akutney/micromouse2020/README.md

# Getting Started

Get started with the following links:

- [Environment Setup](docs/Environment%20Setup.md)
- [Project Structure](docs/Project%20Structure.md)
- [Development Lifecycle](docs/Development%20Lifecycle.md)
