akutney/micromouse2020/Part1.DXF

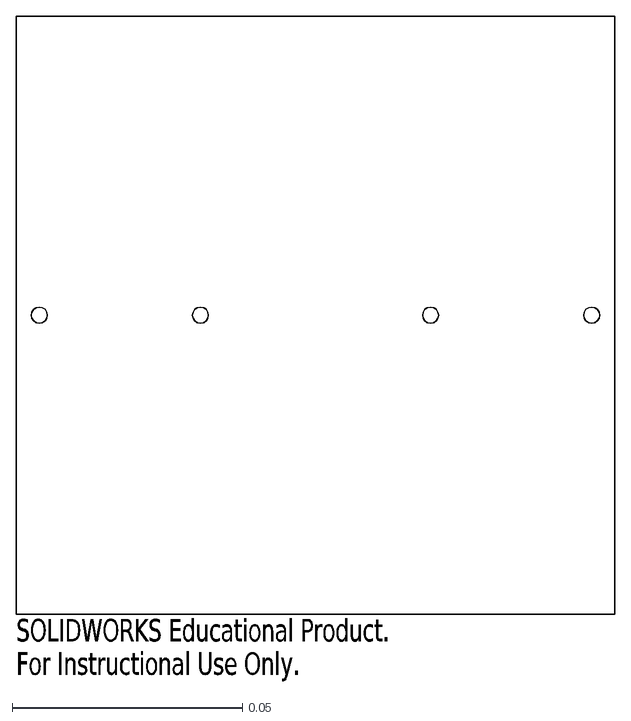
[picture p1: CAD file, 2021-11-04]
Part1.DXF
SOLIDWORKS Educational Product.
For Instructional Use Only.
