akutney/micromouse2020/software/octave/controller/controller_test.png

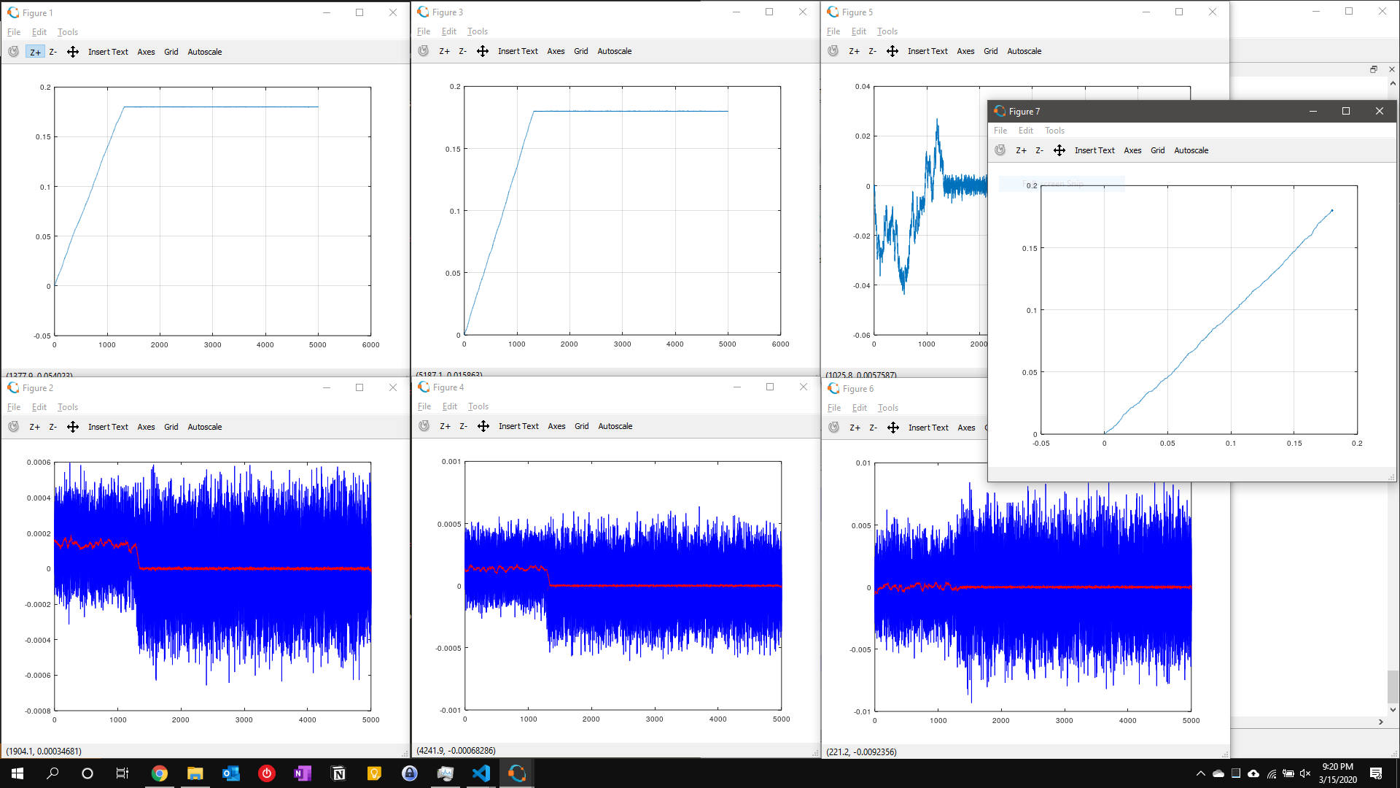
software/octave/controller/controller_test.png
