akutney/micromouse2020/pcb/Rev 1.pdf

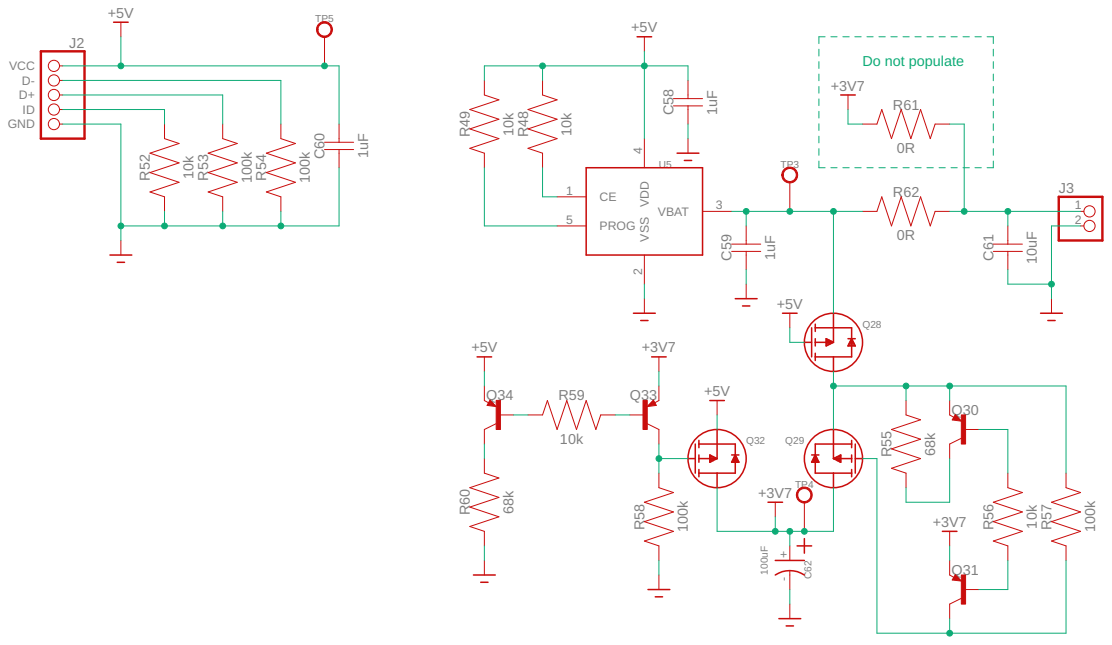
[picture p3: page 1]

1uF 1uF 10k 10k +5V 10k 100k 100k1uF +5V 10uF +5V 68k 10k 100k +3V7 +5V +3V7 100k +3V7 10k +5V 68k 0R0R +3V7 100uF CE 1 VSS 2 VBAT V3 DD 4 PROG 5 U5C58 C59 R48 R49 VCCD- D+ID GND J2 R52 R53 R54C60 12 J3 C61 Q28 Q29 Q30 R55 Q31 R56 R57 Q32 Q33R58 Q34 R59 R60 R61 R62 TP3TP4 TP5 + -C62 Do not populate

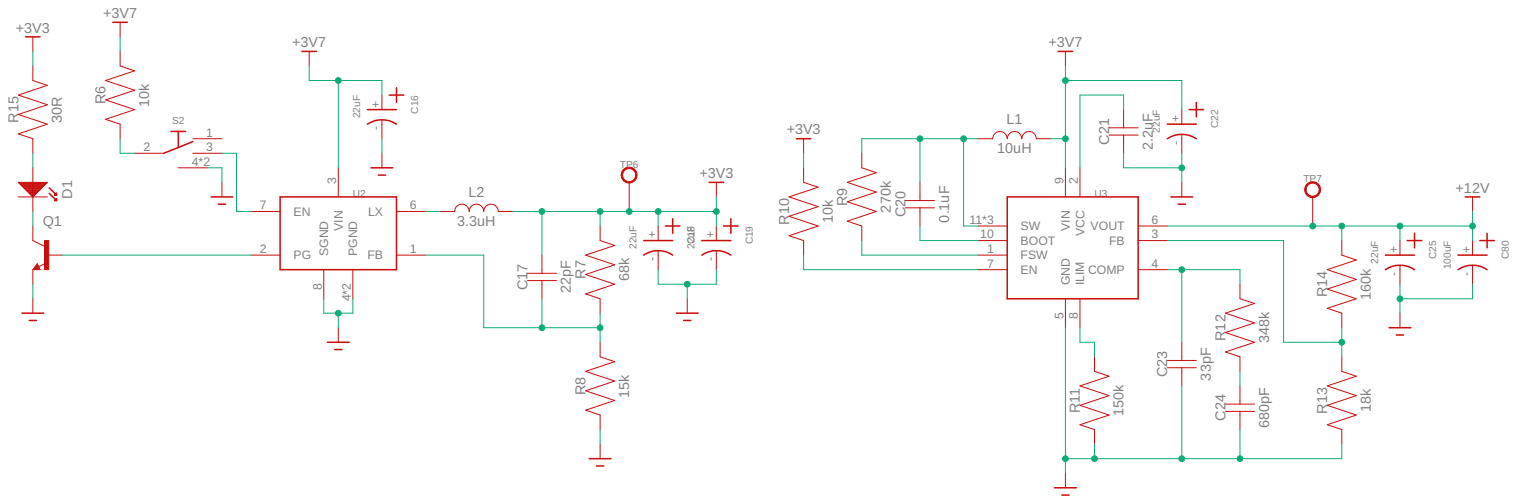
[picture p4: page 2]

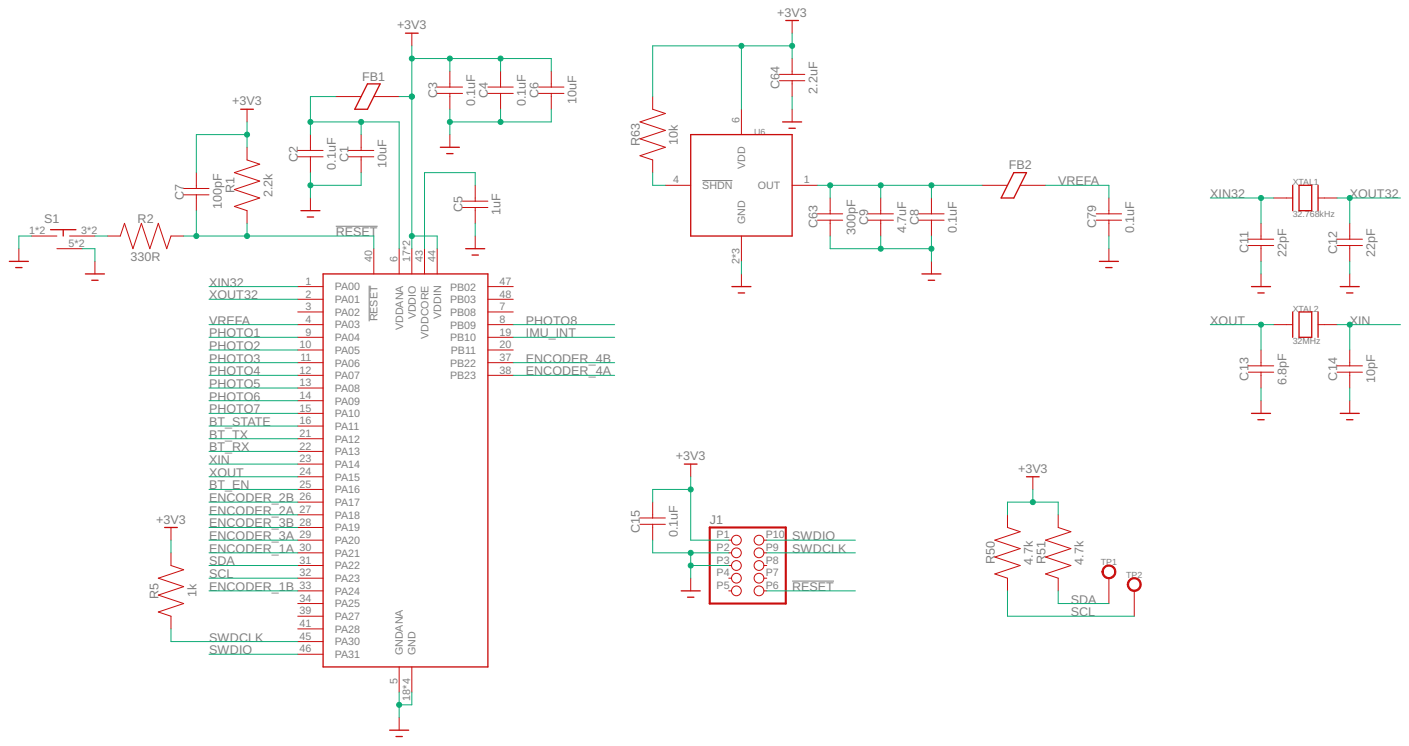
[picture p5: page 3]

10uF 0.1uF 0.1uF 0.1uF 2.2k 10uF +3V3 +3V3 1uF100pF 330R 0.1uF 4.7uF +3V3 32.768kHz 22pF 22pF 32MHz 6.8pF 10pF 1k +3V3 +3V3 0.1uF 4.7k 4.7k +3V3 300pF 10k 2.2uF 0.1uF PA00 1 PA01 2 PA02 3 PA03 4 PA04 9 PA05 10 PA06 11 PA07 12 PA08 13 PA09 14 PA10 15 PA11 16 PA12 21 PA13 22 PA14 23 PA15 24 PA16 25 PA17 26 PA18 27 PA19 28 PA20 29 PA21 30 PA22 31 PA23 32 PA24 33 PA25 34 PA27 39 PA28 41 PA30 45 PA31 46 PB08 7 PB09 8 PB10 19 PB11 20 PB22 37 PB23 38 PB02 47 PB03 48 RESET 40 VDDANA 6 VDDIO 17*2 VDDCORE 43 VDDIN 44 GNDANA 5 GND 18*4 C1 C2 C3 C4 R1 C6 C C5 7 R2 1*2 3*2 5*2 S1 C8 C9 XTAL1 C11 C12 XTAL2 C13 C14 P1 P10 P2 P9 P3 P8 P4 P7 P5 P6 J1 R5 C15 R50 R51 FB1 VDD 6 SHDN 4 GND 2*3 OUT 1 U6 C63 R63 C64 TP1 TP2 FB2 C79 RESET RESET VREFA VREFA XIN32 XIN32 XOUT32 XOUT32 XIN XIN XOUT XOUT SWDIO SWDIO SWDCLK SWDCLK SDA SDA SCL SCL BT_TX BT_RX PHOTO8 PHOTO1 PHOTO2 PHOTO3 PHOTO4 PHOTO5 PHOTO6 PHOTO7 IMU_INT BT_STATE BT_EN ENCODER_2B ENCODER_2A ENCODER_3B ENCODER_3A ENCODER_1A ENCODER_4B ENCODER_4A ENCODER_1B

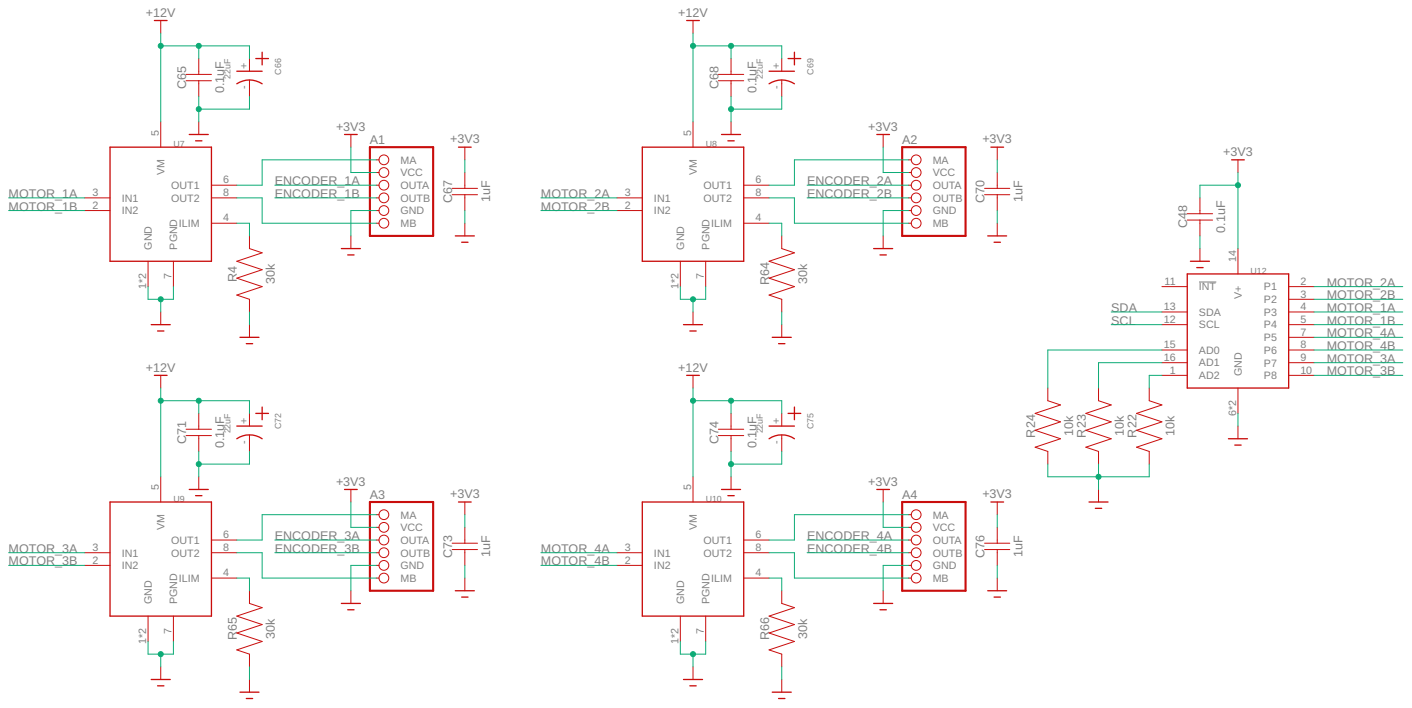
[picture p6: page 4]

30k 0.1uF 22uF +12V +3V3 +3V3 1uF 30k 0.1uF 22uF +12V +3V3 +3V3 1uF 30k 0.1uF 22uF +12V +3V3 +3V3 1uF 30k 0.1uF 22uF +12V +3V3 +3V3 1uF 10k 10k 10k +3V3 0.1uF GND 1*2 PGND 7 IN1 3 IN2 2 OUT1 6 OUT2 8 ILIM 4 VM 5 U7 R4 C65+ - C66 MAVCC OUTA OUTB GND MB A1 C67 GND 1*2 PGND 7 IN1 3 IN2 2 OUT1 6 OUT2 8 ILIM 4 VM 5 U8 R64 C68+ - C69 MAVCC OUTA OUTB GND MB A2 C70 GND 1*2 PGND 7 IN1 3 IN2 2 OUT1 6 OUT2 8 ILIM 4 VM 5 U9 R65 C71+ - C72 MAVCC OUTA OUTB GND MB A3 C73 GND 1*2 PGND 7 IN1 3 IN2 2 OUT1 6 OUT2 8 ILIM 4 VM 5 U10 R66 C74+ - C75 MAVCC OUTA OUTB GND MB A4 C76 P1 2 P2 3 P3 4 P4 5 P5 7 P6 8 P7 9 P8 10 AD0 15 AD1 16 AD2 1 SCL 12 SDA 13 INT 11 GND 6*2 V+ 14 U12 R22 R23 R24 C48 MOTOR_1A MOTOR_1A MOTOR_1B MOTOR_1B ENCODER_1A ENCODER_1B MOTOR_2A MOTOR_2A MOTOR_2B MOTOR_2B ENCODER_2A ENCODER_2B MOTOR_3A MOTOR_3A MOTOR_3B MOTOR_3B ENCODER_3A ENCODER_3B MOTOR_4A MOTOR_4A MOTOR_4B MOTOR_4B ENCODER_4A ENCODER_4B SDA SCL

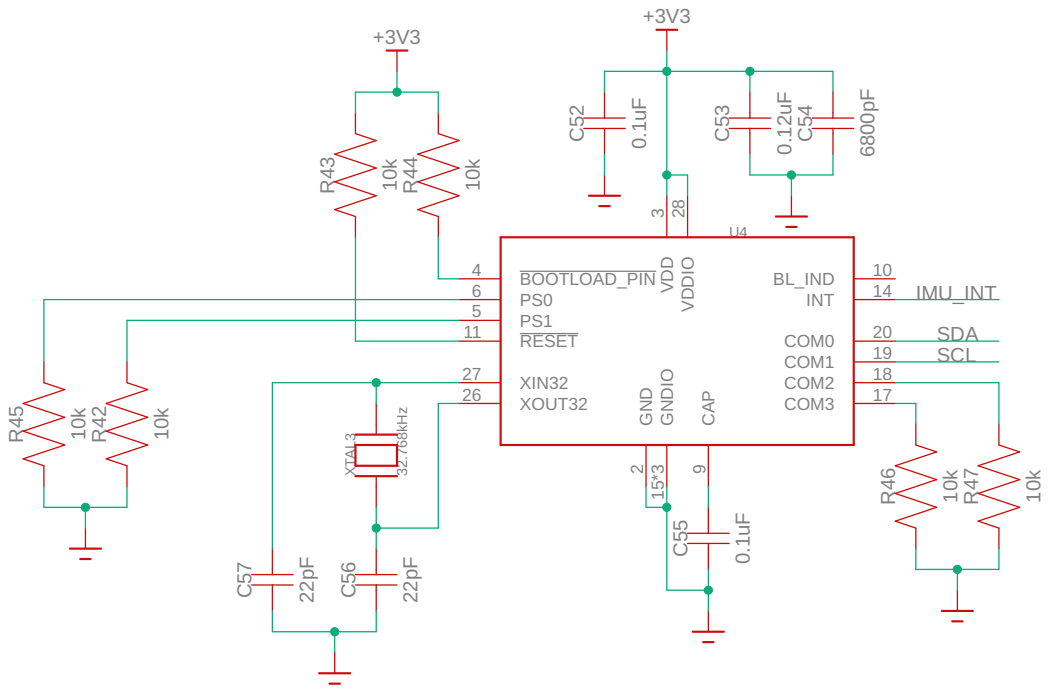
[picture p7: page 5]

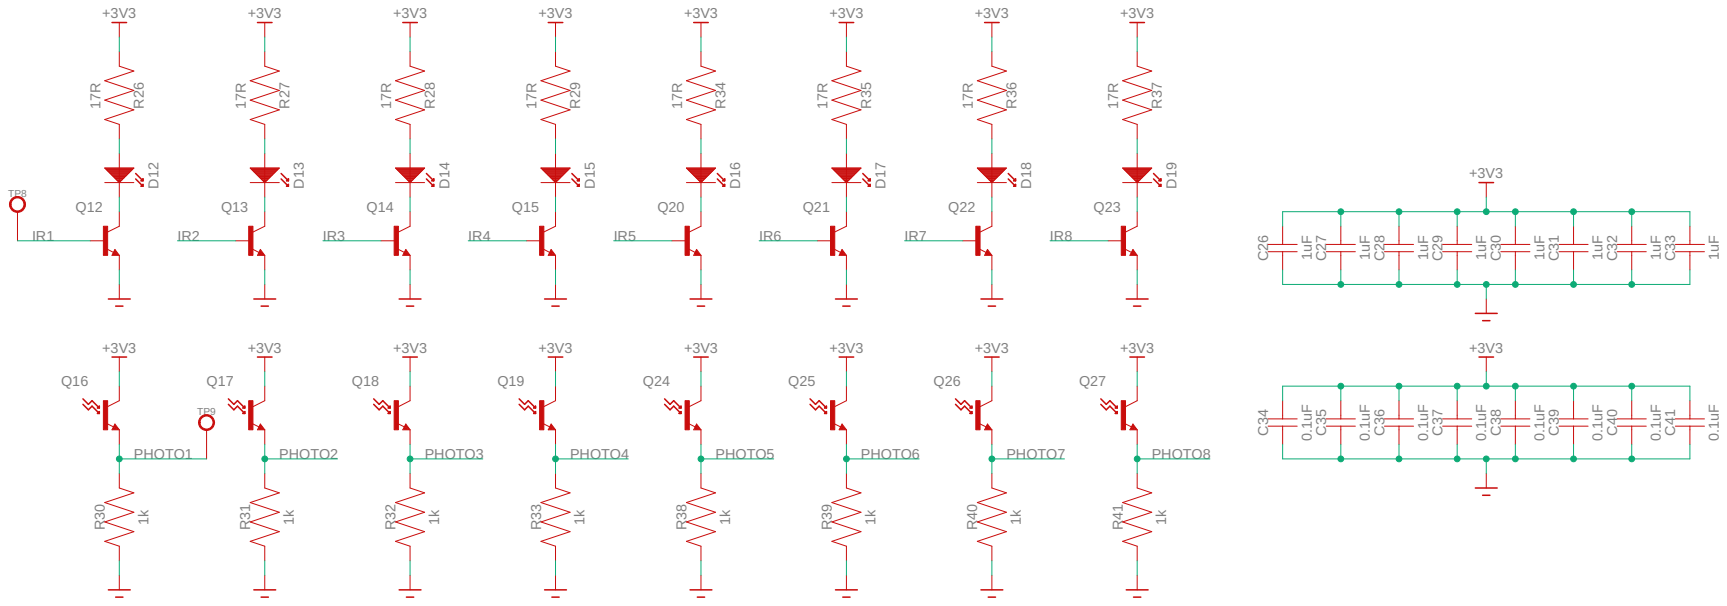
[picture p8: page 6]

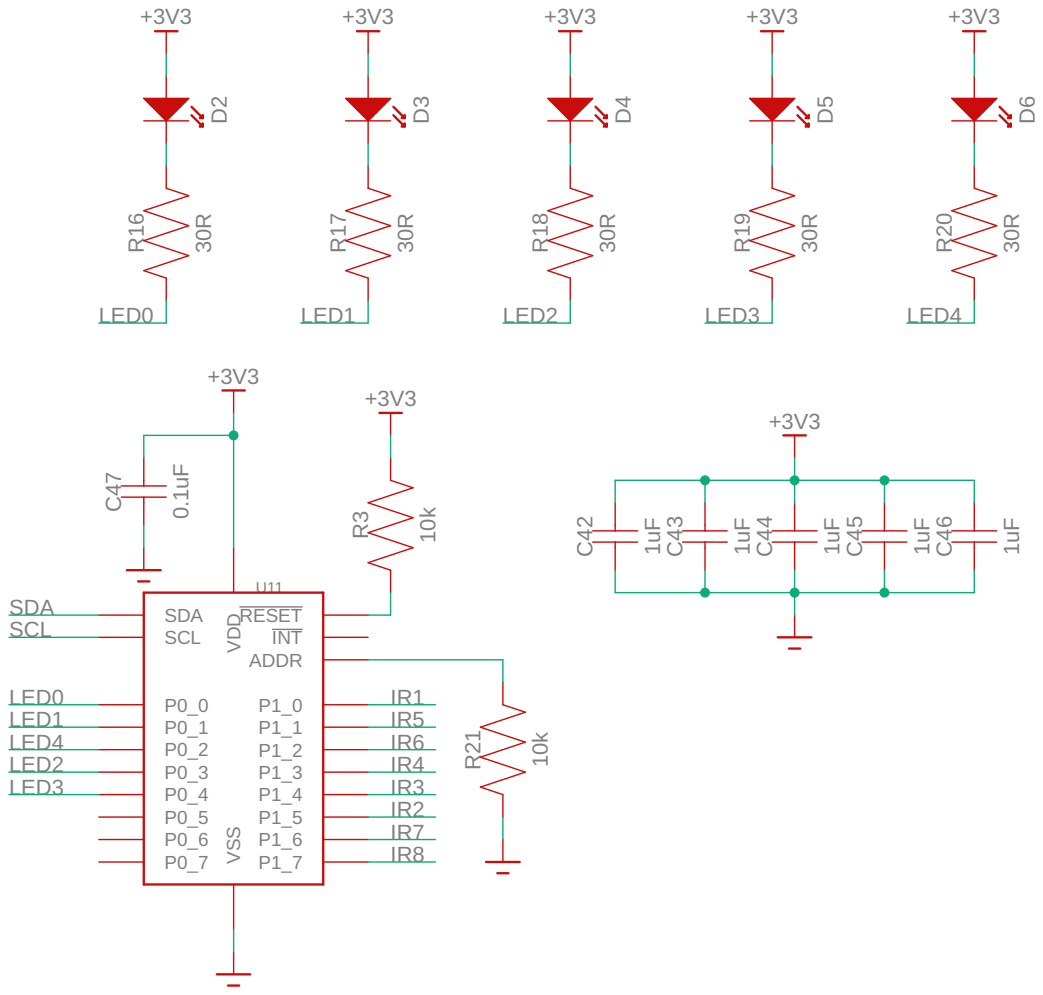
[picture p9: page 7]

INT RESET SCL SDA

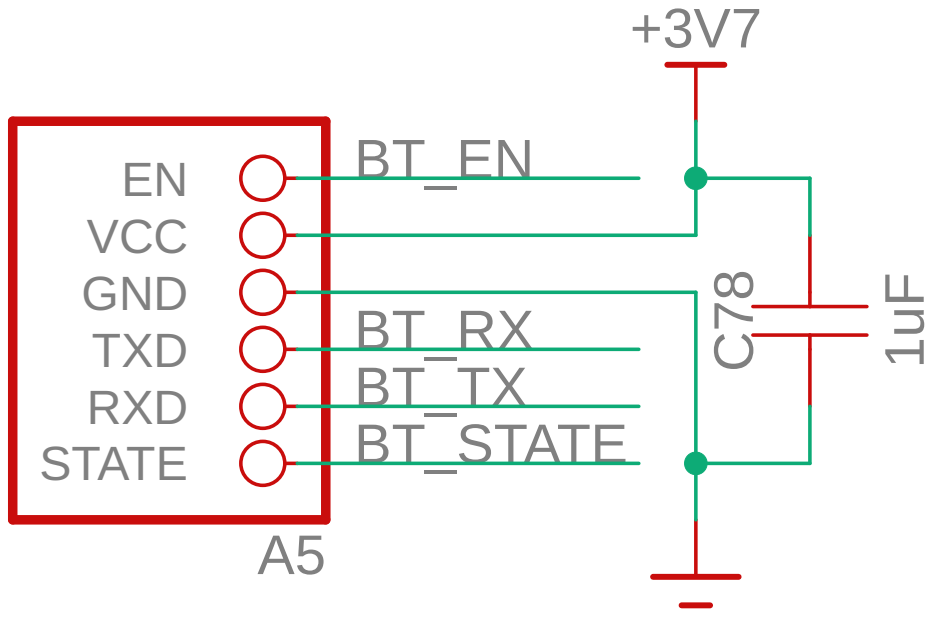
[picture p10: page 8]

1uF +3V7 STATE RXD TXD GND VCCEN A5 C78 BT_RX BT_TX BT_STATE BT_EN
