akutney/micromouse2020/pcb/EncoderR1.pdf

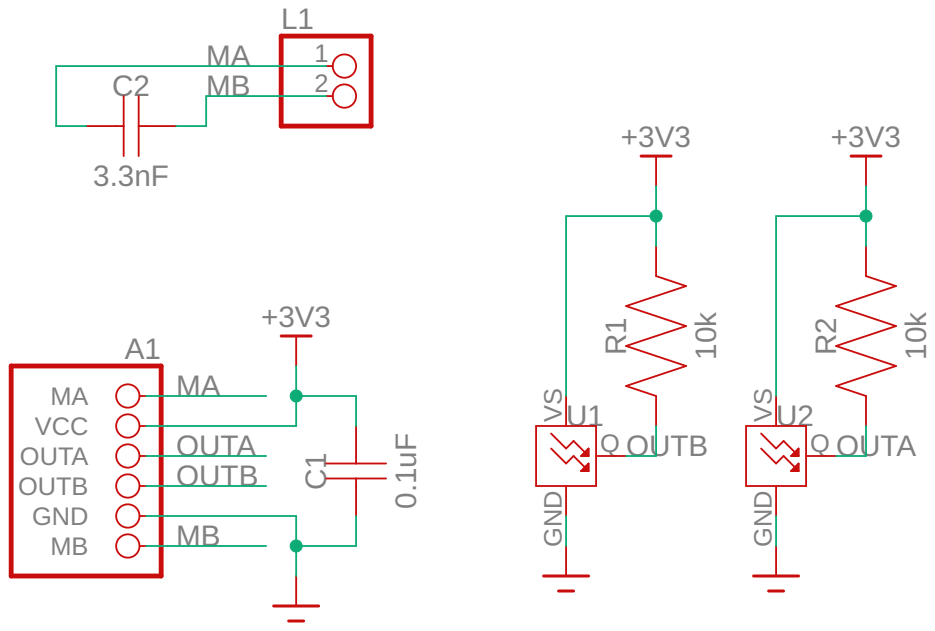
[picture p11: page 1]
