akutney/micromouse2020/pcb/EncoderR1.brd

## EAGLE design pcb/EncoderR1.brd (2020-02-26)

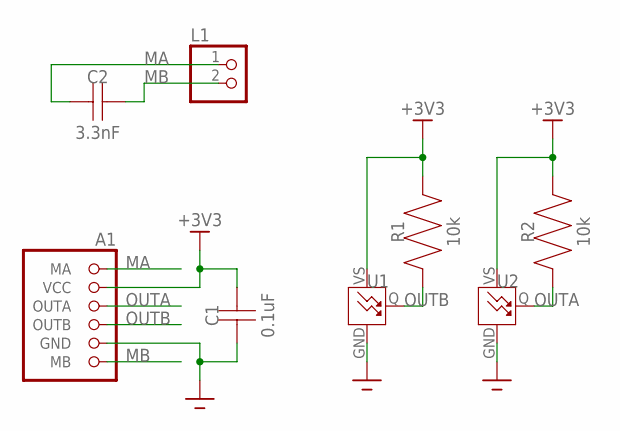
[picture p12: schematic EncoderR1.sch]

Parts:
A1: ENCODER; ENCODER-TAB
C1: 0.1uF; 0603
C2: 3.3nF; 0603
L1: MOTOR
R1, R2: 10k; 0603
U1, U2: TLE49462KHTSA1

Connections:
+3V3: A1.2 (VCC), C1.2, R1.2, R2.2, U1.VS, U2.VS
GND: A1.5 (GND), C1.1, U1.GND, U2.GND
MA: A1.1 (MA), C2.1, L1.1
MB: A1.6 (MB), C2.2, L1.2
OUTA: A1.3 (OUTA), R2.1, U2.Q
OUTB: A1.4 (OUTB), R1.1, U1.Q

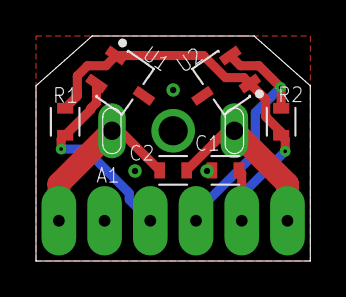
[picture p13: board EncoderR1.brd from above]

Board: 2 copper layers, 15.2 x 12.5 mm, 8 parts (0 on the bottom side), 6 nets.
