akutney/micromouse2020/pcb/Rev 1.brd

## EAGLE design pcb/Rev 1.brd (2020-02-26)

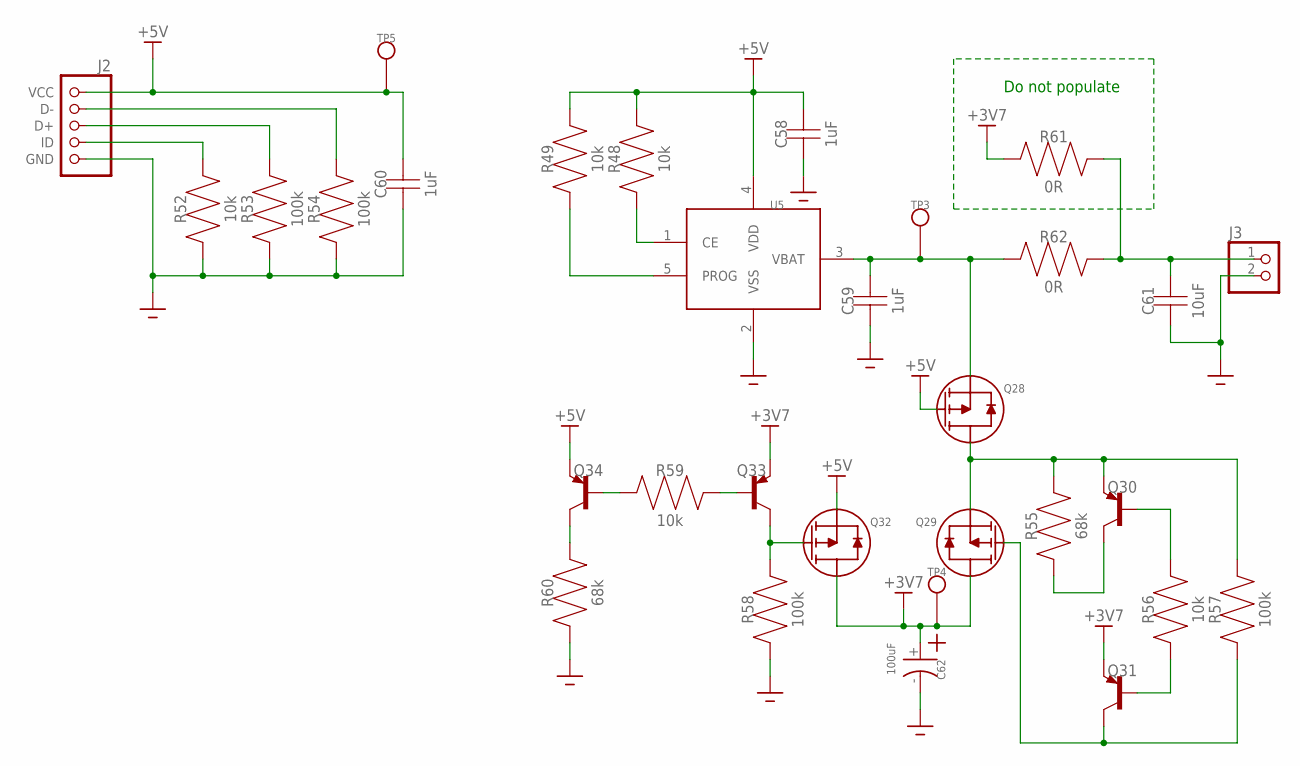
[picture p14: schematic Rev 1.sch, sheet 1, Battery and Charger]

Parts:
C58, C59, C60: 1uF; 0805
C61: 10uF; 0805
C62: 100uF; EEE-1EA101AP
J2: 10118194-0001LF
J3: B2B-PH-K-S(LF)(SN)
Q28, Q29, Q32: SI7157DP
Q30, Q31, Q33, Q34: MMBT3906; SOT96P237X112-3
R48, R49, R52: 10k; 0402
R53, R54: 100k; 0402
R55: 68k; 0603
R56: 10k; 0603
R57: 100k; 0603
R58: 100k; 0805
R59: 10k; 0805
R60: 68k; 0805
R61, R62: 0R; 0805
TP3, TP4, TP5: TESTPOINT
U5: MCP73811

Connections:
+3V7: C62.+, Q29.5 (D), Q29.6 (D), Q29.7 (D), Q29.8 (D), Q29.9 (D), Q29.10 (D), Q29.11 (D), Q31.2 (E), Q32.5 (D), Q32.6 (D), Q32.7 (D), Q32.8 (D), Q32.9 (D), Q32.10 (D), Q32.11 (D), Q33.2 (E), R61.P$1, TP4.P1; also elsewhere on the board
+5V: C58.P$2, C60.P$2, J2.1 (VCC), Q28.4 (G), Q32.1 (S), Q32.2 (S), Q32.3 (S), Q34.2 (E), R48.2, R49.2, TP5.P1, U5.4 (VDD)
GND: C58.P$1, C59.P$1, C60.P$1, C61.P$1, C62.-, J2.5 (GND), J2.6 (GND), J2.7 (GND), J2.8 (GND), J2.9 (GND), J2.10 (GND), J2.11 (GND), J2.12 (GND), J2.13 (GND), J2.14 (GND), J2.15 (GND), J3.2, R52.1, R53.1, R54.1, R58.P$1, R60.P$1, U5.2 (VSS); also elsewhere on the board
unnamed: C59.P$2, Q28.1 (S), Q28.2 (S), Q28.3 (S), R62.P$1, TP3.P1, U5.3 (VBAT)
unnamed: R48.1, U5.1 (CE)
unnamed: R49.1, U5.5 (PROG)
unnamed: Q30.3 (C), R55.1
unnamed: Q28.5 (D), Q28.6 (D), Q28.7 (D), Q28.8 (D), Q28.9 (D), Q28.10 (D), Q28.11 (D), Q29.1 (S), Q29.2 (S), Q29.3 (S), Q30.2 (E), R55.2, R57.2
unnamed: Q31.1 (B), R56.1
unnamed: Q30.1 (B), R56.2
unnamed: J2.4 (ID), R52.2
unnamed: J2.3 (D+), R53.2
unnamed: J2.2 (D-), R54.2
unnamed: Q29.4 (G), Q31.3 (C), R57.1
unnamed: Q32.4 (G), Q33.3 (C), R58.P$2
unnamed: Q34.1 (B), R59.P$1
unnamed: Q33.1 (B), R59.P$2
unnamed: Q34.3 (C), R60.P$2
unnamed: C61.P$2, J3.1, R61.P$2, R62.P$2

Notes on the sheet:
Do not populate

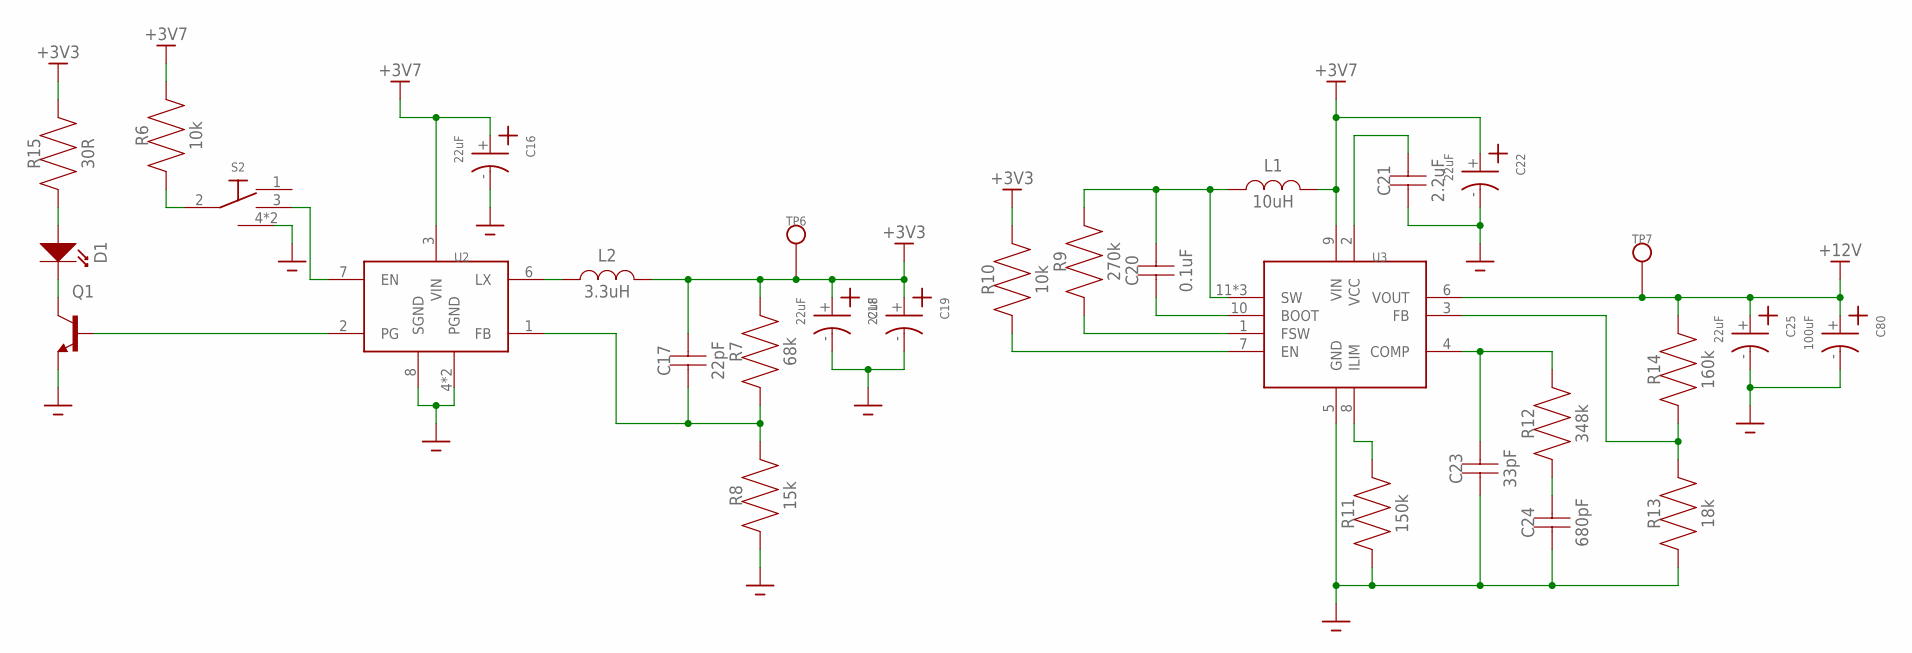
[picture p15: schematic Rev 1.sch, sheet 2, Power Regulation]

Parts:
C16, C18, C19, C22, C25: 22uF; 865080542006
C17: 22pF; 0805
C20: 0.1uF; 0402
C21: 2.2uF; 0402
C23: 33pF; 0402
C24: 680pF; 0402
C80: 100uF; EEE-1EA101AP
D1: LED1206; 1206
L1: 10uH; 104CDMCC
L2: 3.3uH; NRS5040
Q1: MMBT3904,215MMBT3904,215; SOT95P230X110-3
R6: 10k; 0805
R7: 68k; 0805
R8: 15k; 0805
R9: 270k; 0402
R10: 10k; 0603
R11: 150k; 0603
R12: 348k; 0402
R13: 18k; 0402
R14: 160k; 0402
R15: 30R; 0805
S2: OS102011MS2QN1
TP6, TP7: TESTPOINT
U2: AP3441
U3: TPS61089

Connections:
+3V3: C17.P$2, C18.+, C19.+, L2.2, R7.P$2, R10.2, R15.P$2, TP6.P1; also elsewhere on the board
+3V7: C16.+, C22.+, L1.2, R6.P$2, U2.3 (VIN), U3.9 (VIN); also elsewhere on the board
+12V: C25.+, C80.+, R14.2, TP7.P1, U3.6 (VOUT); also elsewhere on the board
GND: C16.-, C18.-, C19.-, C21.1, C22.-, C23.1, C24.1, C25.-, C80.-, Q1.2 (E), R8.P$1, R11.1, R13.1, S2.4 (GND), S2.5 (GND), U2.4 (PGND), U2.8 (SGND), U2.9 (PGND), U3.5 (GND); also elsewhere on the board
unnamed: L2.1, U2.6 (LX)
unnamed: C17.P$1, R7.P$1, R8.P$2, U2.1 (FB)
unnamed: S2.3 (2), U2.7 (EN)
unnamed: R6.P$1, S2.2 (COMMON)
unnamed: C20.1, U3.10 (BOOT)
unnamed: R9.1, U3.1 (FSW)
unnamed: C20.2, L1.1, R9.2, U3.11 (SW), U3.12 (SW), U3.13 (SW)
unnamed: R11.2, U3.8 (ILIM)
unnamed: C21.2, U3.2 (VCC)
unnamed: C23.2, R12.2, U3.4 (COMP)
unnamed: R10.1, U3.7 (EN)
unnamed: C24.2, R12.1
unnamed: Q1.1 (B), U2.2 (PG)
unnamed: R13.2, R14.1, U3.3 (FB)
unnamed: D1.2 (OUT), Q1.3 (C)
unnamed: D1.1 (IN), R15.P$1

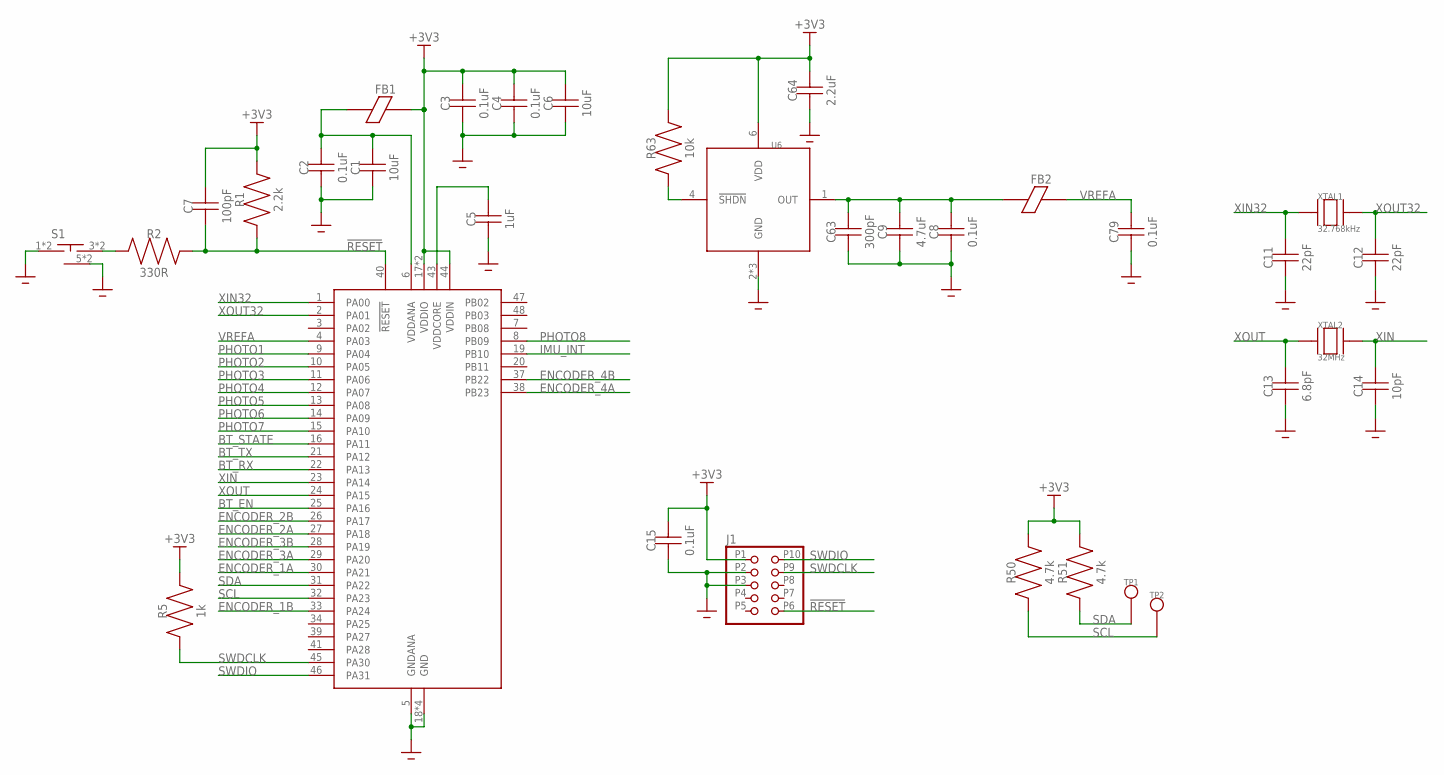
[picture p16: schematic Rev 1.sch, sheet 3, MCU]

Parts:
C1, C6: 10uF; 0402
C2, C3, C4, C8, C79: 0.1uF; 0402
C5: 1uF; 0402
C7: 100pF; 0603
C9: 4.7uF; 0402
C11, C12: 22pF; 0402
C13: 6.8pF; 0402
C14: 10pF; 0402
C15: 0.1uF; 0603
C63: 300pF; 0402
C64: 2.2uF; 0402
FB1, FB2: FERRITE0402; 0402
J1: 3220-10-0100-00
R1: 2.2k; 0603
R2: 330R; 0805
R5: 1k; 0603
R50, R51: 4.7k; 0603
R63: 10k; 0402
S1: PTS526SMG15SMTR2LFS
TP1, TP2: TESTPOINT
U1: ATSAMD21G18A-MU
U6: MCP1501
XTAL1: 32.768kHz; FC-135
XTAL2: 32MHz; XRCGB

Connections:
!RESET: C7.1, J1.P6 (6), R1.1, R2.P$2, U1.40 (!RESET)
+3V3: C3.2, C4.2, C6.2, C7.2, C15.2, C64.2, FB1.2, J1.P1 (1), R1.2, R5.2, R50.2, R51.2, R63.2, U1.17 (VDDIO), U1.36 (VDDIO), U1.44 (VDDIN), U6.6 (VDD); also elsewhere on the board
BT_EN: U1.25 (PA16); also elsewhere on the board
BT_RX: U1.22 (PA13); also elsewhere on the board
BT_STATE: U1.16 (PA11); also elsewhere on the board
BT_TX: U1.21 (PA12); also elsewhere on the board
ENCODER_1A: U1.30 (PA21); also elsewhere on the board
ENCODER_1B: U1.33 (PA24); also elsewhere on the board
ENCODER_2A: U1.27 (PA18); also elsewhere on the board
ENCODER_2B: U1.26 (PA17); also elsewhere on the board
ENCODER_3A: U1.29 (PA20); also elsewhere on the board
ENCODER_3B: U1.28 (PA19); also elsewhere on the board
ENCODER_4A: U1.38 (PB23); also elsewhere on the board
ENCODER_4B: U1.37 (PB22); also elsewhere on the board
GND: C1.1, C2.1, C3.1, C4.1, C5.1, C6.1, C8.1, C9.1, C11.1, C12.1, C13.1, C14.1, C15.1, C63.1, C64.1, C79.1, J1.P2 (2), J1.P3 (3), S1.1, S1.2 (1), S1.5 (GND), S1.6 (GND), U1.5 (GNDANA), U1.18 (GND), U1.35 (GND), U1.42 (GND), U1.49 (GND), U6.2 (GND), U6.3 (GND), U6.5 (GND); also elsewhere on the board
IMU_INT: U1.19 (PB10); also elsewhere on the board
unnamed: R2.P$1, S1.3 (2), S1.4 (2)
unnamed: C5.2, U1.43 (VDDCORE)
unnamed: C1.2, C2.2, FB1.1, U1.6 (VDDANA)
unnamed: R63.1, U6.4 (!SHDN)
unnamed: C8.2, C9.2, C63.2, FB2.1, U6.1 (OUT)
PHOTO1: U1.9 (PA04); also elsewhere on the board
PHOTO2: U1.10 (PA05); also elsewhere on the board
PHOTO3: U1.11 (PA06); also elsewhere on the board
PHOTO4: U1.12 (PA07); also elsewhere on the board
PHOTO5: U1.13 (PA08); also elsewhere on the board
PHOTO6: U1.14 (PA09); also elsewhere on the board
PHOTO7: U1.15 (PA10); also elsewhere on the board
PHOTO8: U1.8 (PB09); also elsewhere on the board
SCL: R50.1, TP2.P1, U1.32 (PA23); also elsewhere on the board
SDA: R51.1, TP1.P1, U1.31 (PA22); also elsewhere on the board
SWDCLK: J1.P9 (9), R5.1, U1.45 (PA30)
SWDIO: J1.P10 (10), U1.46 (PA31)
VREFA: C79.2, FB2.2, U1.4 (PA03)
XIN: C14.2, U1.23 (PA14), XTAL2.2, XTAL2.4
XIN32: C11.2, U1.1 (PA00), XTAL1.1
XOUT: C13.2, U1.24 (PA15), XTAL2.1, XTAL2.3
XOUT32: C12.2, U1.2 (PA01), XTAL1.2

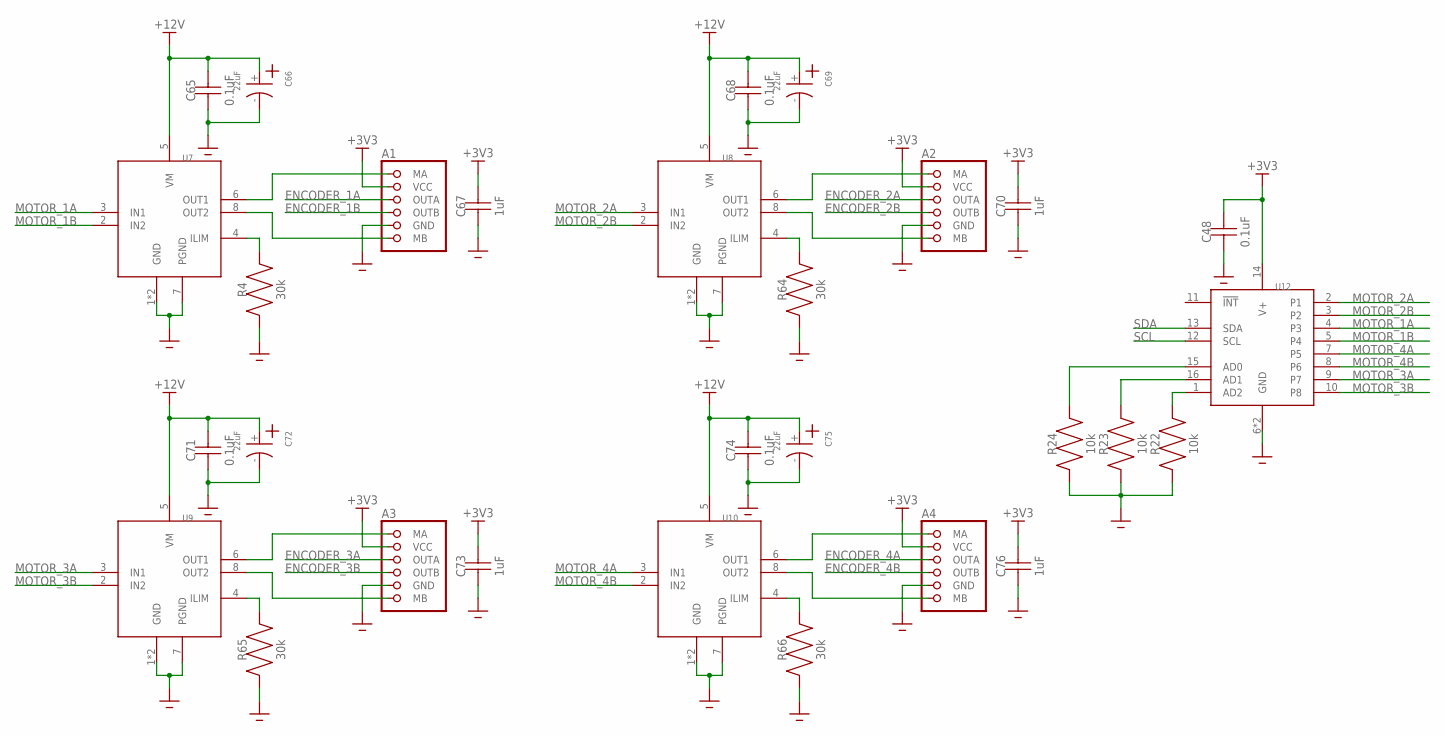
[picture p17: schematic Rev 1.sch, sheet 4, Motor Drivers and Encoders]

Parts:
A1, A2, A3, A4: ENCODERSLOT; ENCODER-SLOT
C48: 0.1uF; 0603
C65, C68, C71, C74: 0.1uF; 0805
C66, C69, C72, C75: 22uF; 865080542006
C67, C70, C73, C76: 1uF; 0805
R4, R64, R65, R66: 30k; 0805
R22, R23, R24: 10k; 0603
U7, U8, U9, U10: DRV8871
U12: MAX7315

Connections:
+3V3: A1.2 (VCC), A2.2 (VCC), A3.2 (VCC), A4.2 (VCC), C48.2, C67.P$2, C70.P$2, C73.P$2, C76.P$2, U12.14 (V+); also elsewhere on the board
+12V: C65.P$2, C66.+, C68.P$2, C69.+, C71.P$2, C72.+, C74.P$2, C75.+, U7.5 (VM), U8.5 (VM), U9.5 (VM), U10.5 (VM); also elsewhere on the board
ENCODER_1A: A1.3 (OUTA); also elsewhere on the board
ENCODER_1B: A1.4 (OUTB); also elsewhere on the board
ENCODER_2A: A2.3 (OUTA); also elsewhere on the board
ENCODER_2B: A2.4 (OUTB); also elsewhere on the board
ENCODER_3A: A3.3 (OUTA); also elsewhere on the board
ENCODER_3B: A3.4 (OUTB); also elsewhere on the board
ENCODER_4A: A4.3 (OUTA); also elsewhere on the board
ENCODER_4B: A4.4 (OUTB); also elsewhere on the board
GND: A1.5 (GND), A2.5 (GND), A3.5 (GND), A4.5 (GND), C48.1, C65.P$1, C66.-, C67.P$1, C68.P$1, C69.-, C70.P$1, C71.P$1, C72.-, C73.P$1, C74.P$1, C75.-, C76.P$1, R4.P$1, R22.1, R23.1, R24.1, R64.P$1, R65.P$1, R66.P$1, U7.1 (GND), U7.7 (PGND), U7.9 (GND), U8.1 (GND), U8.7 (PGND), U8.9 (GND), U9.1 (GND), U9.7 (PGND), U9.9 (GND), U10.1 (GND), U10.7 (PGND), U10.9 (GND), U12.6 (GND), U12.17 (GND); also elsewhere on the board
MOTOR_1A: U7.3 (IN1), U12.4 (P3)
MOTOR_1B: U7.2 (IN2), U12.5 (P4)
MOTOR_2A: U8.3 (IN1), U12.2 (P1)
MOTOR_2B: U8.2 (IN2), U12.3 (P2)
MOTOR_3A: U9.3 (IN1), U12.9 (P7)
MOTOR_3B: U9.2 (IN2), U12.10 (P8)
MOTOR_4A: U10.3 (IN1), U12.7 (P5)
MOTOR_4B: U10.2 (IN2), U12.8 (P6)
unnamed: R22.2, U12.1 (AD2)
unnamed: R23.2, U12.16 (AD1)
unnamed: R24.2, U12.15 (AD0)
unnamed: A1.1 (MA), U7.6 (OUT1)
unnamed: R4.P$2, U7.4 (ILIM)
unnamed: A1.6 (MB), U7.8 (OUT2)
unnamed: R64.P$2, U8.4 (ILIM)
unnamed: A2.1 (MA), U8.6 (OUT1)
unnamed: A2.6 (MB), U8.8 (OUT2)
unnamed: R65.P$2, U9.4 (ILIM)
unnamed: A3.1 (MA), U9.6 (OUT1)
unnamed: A3.6 (MB), U9.8 (OUT2)
unnamed: R66.P$2, U10.4 (ILIM)
unnamed: A4.1 (MA), U10.6 (OUT1)
unnamed: A4.6 (MB), U10.8 (OUT2)
SCL: U12.12 (SCL); also elsewhere on the board
SDA: U12.13 (SDA); also elsewhere on the board

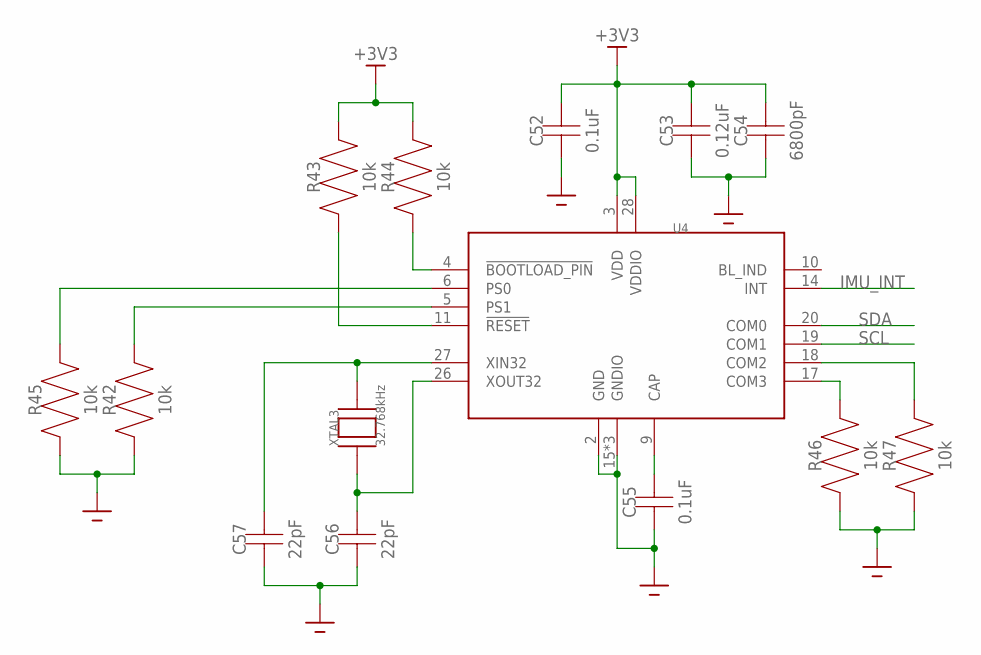
[picture p18: schematic Rev 1.sch, sheet 5, IMU]

Parts:
C52, C55: 0.1uF; 0603
C53: 0.12uF; 0603
C54: 6800pF; 0603
C56, C57: 22pF; 0603
R42, R43, R44, R45, R46, R47: 10k; 0603
U4: BNO055
XTAL3: 32.768kHz; FC-135

Connections:
+3V3: C52.2, C53.2, C54.2, R43.2, R44.2, U4.3 (VDD), U4.28 (VDDIO); also elsewhere on the board
GND: C52.1, C53.1, C54.1, C55.1, C56.1, C57.1, R42.1, R45.1, R46.1, R47.1, U4.2 (GND), U4.15 (GNDIO), U4.16 (GNDIO), U4.25 (GNDIO); also elsewhere on the board
IMU_INT: U4.14 (INT); also elsewhere on the board
unnamed: C55.2, U4.9 (CAP)
unnamed: R44.1, U4.4 (!BOOTLOAD_PIN)
unnamed: C56.2, U4.26 (XOUT32), XTAL3.1
unnamed: R42.2, U4.5 (PS1)
unnamed: C57.2, U4.27 (XIN32), XTAL3.2
unnamed: R45.2, U4.6 (PS0)
unnamed: R43.1, U4.11 (!RESET)
unnamed: R46.2, U4.17 (COM3)
unnamed: R47.2, U4.18 (COM2)
SCL: U4.19 (COM1); also elsewhere on the board
SDA: U4.20 (COM0); also elsewhere on the board

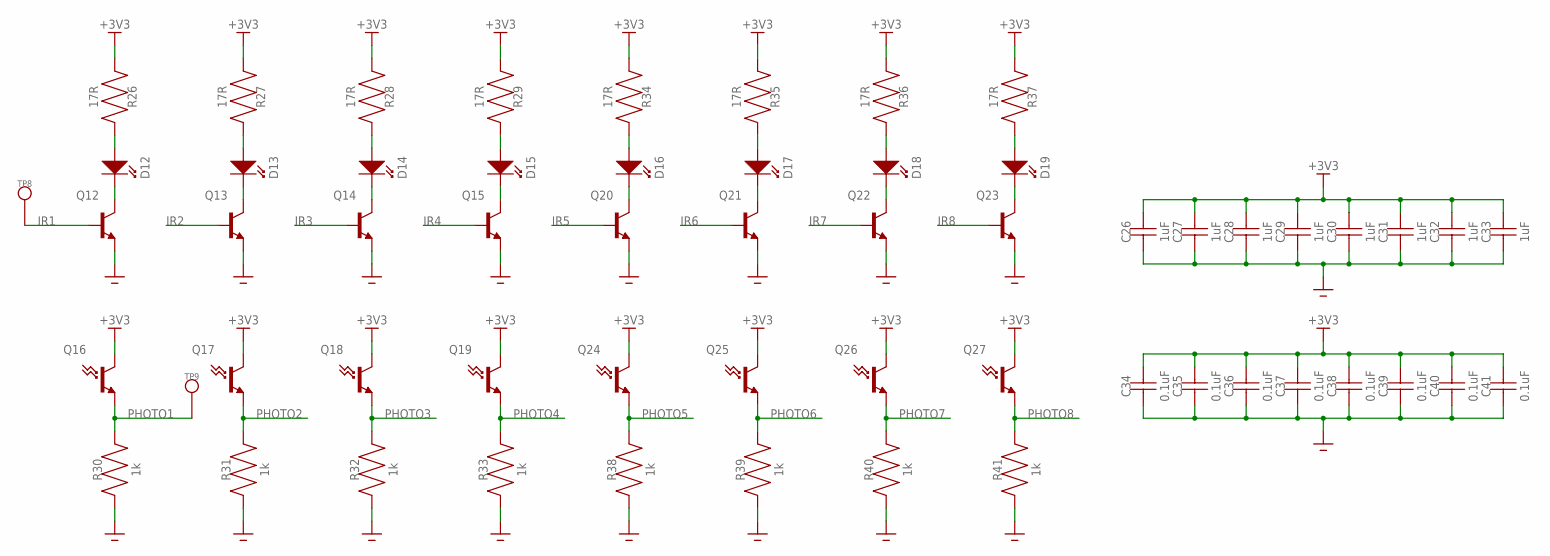
[picture p19: schematic Rev 1.sch, sheet 6, IR Sensors]

Parts:
C26, C27, C28, C29, C30, C31, C32: 1uF; 0805
C33: 1uF; 0603
C34, C35, C36, C37, C38, C39, C41: 0.1uF; 0805
C40: 0.1uF; 0603
D12, D13, D14, D15, D16, D17, D18, D19: SFH4545
Q12, Q13, Q14, Q15, Q20, Q21, Q22, Q23: MMBT3904,215MMBT3904,215; SOT95P230X110-3
Q16, Q17, Q18, Q19, Q24, Q25, Q26, Q27: TEFT4300
R26, R27, R28, R29, R34, R35, R36, R37: 17R; 0805
R30, R31, R32, R33, R38, R39, R41: 1k; 0805
R40: 1k; 0603
TP8, TP9: TESTPOINT

Connections:
+3V3: C26.P$2, C27.P$2, C28.P$2, C29.P$2, C30.P$2, C31.P$2, C32.P$2, C33.2, C34.P$2, C35.P$2, C36.P$2, C37.P$2, C38.P$2, C39.P$2, C40.2, C41.P$2, Q16.C, Q17.C, Q18.C, Q19.C, Q24.C, Q25.C, Q26.C, Q27.C, R26.P$1, R27.P$1, R28.P$1, R29.P$1, R34.P$1, R35.P$1, R36.P$1, R37.P$1; also elsewhere on the board
GND: C26.P$1, C27.P$1, C28.P$1, C29.P$1, C30.P$1, C31.P$1, C32.P$1, C33.1, C34.P$1, C35.P$1, C36.P$1, C37.P$1, C38.P$1, C39.P$1, C40.1, C41.P$1, Q12.2 (E), Q13.2 (E), Q14.2 (E), Q15.2 (E), Q20.2 (E), Q21.2 (E), Q22.2 (E), Q23.2 (E), R30.P$1, R31.P$1, R32.P$1, R33.P$1, R38.P$1, R39.P$1, R40.1, R41.P$1; also elsewhere on the board
IR1: Q12.1 (B), TP8.P1; also elsewhere on the board
IR2: Q13.1 (B); also elsewhere on the board
IR3: Q14.1 (B); also elsewhere on the board
IR4: Q15.1 (B); also elsewhere on the board
IR5: Q20.1 (B); also elsewhere on the board
IR6: Q21.1 (B); also elsewhere on the board
IR7: Q22.1 (B); also elsewhere on the board
IR8: Q23.1 (B); also elsewhere on the board
unnamed: D12.- (OUT), Q12.3 (C)
unnamed: D12.+ (IN), R26.P$2
unnamed: D13.- (OUT), Q13.3 (C)
unnamed: D13.+ (IN), R27.P$2
unnamed: D14.- (OUT), Q14.3 (C)
unnamed: D14.+ (IN), R28.P$2
unnamed: D15.- (OUT), Q15.3 (C)
unnamed: D15.+ (IN), R29.P$2
unnamed: D16.- (OUT), Q20.3 (C)
unnamed: D16.+ (IN), R34.P$2
unnamed: D17.- (OUT), Q21.3 (C)
unnamed: D17.+ (IN), R35.P$2
unnamed: D18.- (OUT), Q22.3 (C)
unnamed: D18.+ (IN), R36.P$2
unnamed: D19.- (OUT), Q23.3 (C)
unnamed: D19.+ (IN), R37.P$2
PHOTO1: Q16.E, R30.P$2, TP9.P1; also elsewhere on the board
PHOTO2: Q17.E, R31.P$2; also elsewhere on the board
PHOTO3: Q18.E, R32.P$2; also elsewhere on the board
PHOTO4: Q19.E, R33.P$2; also elsewhere on the board
PHOTO5: Q24.E, R38.P$2; also elsewhere on the board
PHOTO6: Q25.E, R39.P$2; also elsewhere on the board
PHOTO7: Q26.E, R40.2; also elsewhere on the board
PHOTO8: Q27.E, R41.P$2; also elsewhere on the board

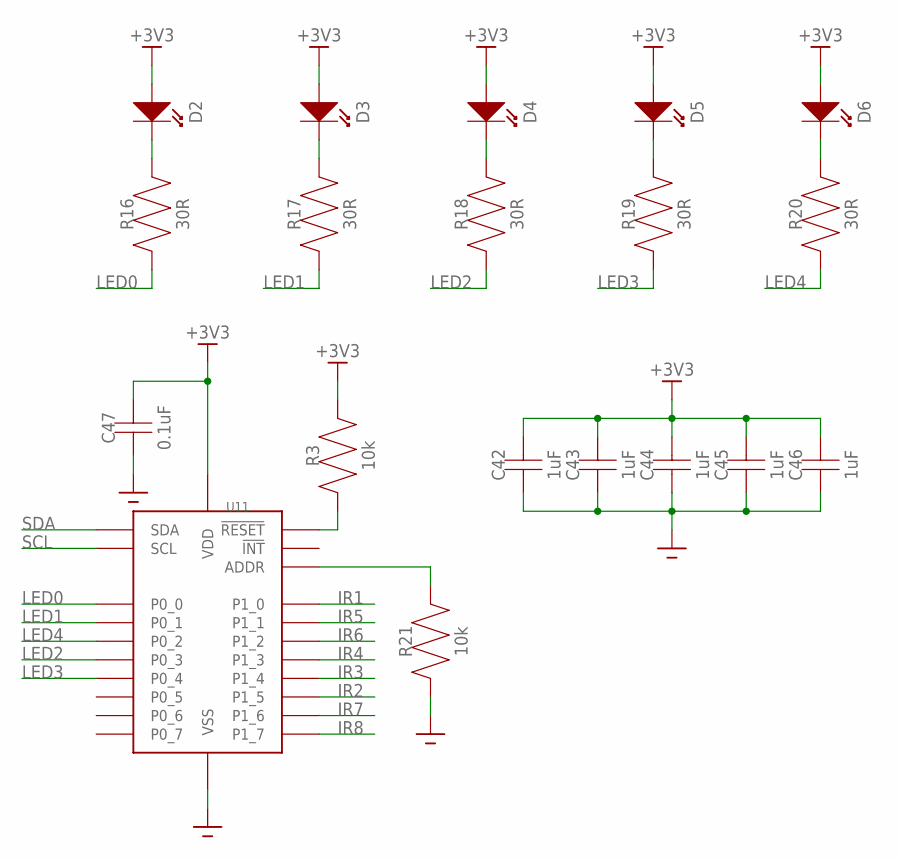
[picture p20: schematic Rev 1.sch, sheet 7, LEDs]

Parts:
C42, C43, C44, C45, C46: 1uF; 0603
C47: 0.1uF; 0603
D2, D3, D4, D5, D6: LED1206; 1206
R3, R21: 10k; 0603
R16, R17, R18, R19, R20: 30R; 0603
U11: PCAL6416A

Connections:
+3V3: C42.2, C43.2, C44.2, C45.2, C46.2, C47.2, D2.1 (IN), D3.1 (IN), D4.1 (IN), D5.1 (IN), D6.1 (IN), R3.2, U11.21 (VDD), U11.23 (VDD); also elsewhere on the board
GND: C42.1, C43.1, C44.1, C45.1, C46.1, C47.1, R21.1, U11.9 (VSS), U11.25 (VSS); also elsewhere on the board
IR1: U11.10 (P1_0); also elsewhere on the board
IR2: U11.15 (P1_5); also elsewhere on the board
IR3: U11.14 (P1_4); also elsewhere on the board
IR4: U11.13 (P1_3); also elsewhere on the board
IR5: U11.11 (P1_1); also elsewhere on the board
IR6: U11.12 (P1_2); also elsewhere on the board
IR7: U11.16 (P1_6); also elsewhere on the board
IR8: U11.17 (P1_7); also elsewhere on the board
LED0: R16.1, U11.1 (P0_0)
LED1: R17.1, U11.2 (P0_1)
LED2: R18.1, U11.4 (P0_3)
LED3: R19.1, U11.5 (P0_4)
LED4: R20.1, U11.3 (P0_2)
unnamed: D2.2 (OUT), R16.2
unnamed: D3.2 (OUT), R17.2
unnamed: D4.2 (OUT), R18.2
unnamed: D5.2 (OUT), R19.2
unnamed: D6.2 (OUT), R20.2
unnamed: R3.1, U11.24 (!RESET)
unnamed: R21.2, U11.18 (ADDR)
SCL: U11.19 (SCL); also elsewhere on the board
SDA: U11.20 (SDA); also elsewhere on the board

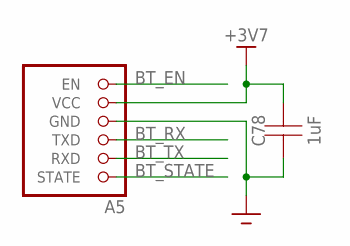
[picture p21: schematic Rev 1.sch, sheet 8, Bluetooth]

Parts:
A5: HC-05
C78: 1uF; 0603

Connections:
+3V7: A5.5 (VCC), C78.2; also elsewhere on the board
BT_EN: A5.6 (EN); also elsewhere on the board
BT_RX: A5.3 (TXD); also elsewhere on the board
BT_STATE: A5.1 (STATE); also elsewhere on the board
BT_TX: A5.2 (RXD); also elsewhere on the board
GND: A5.4 (GND), C78.1; also elsewhere on the board

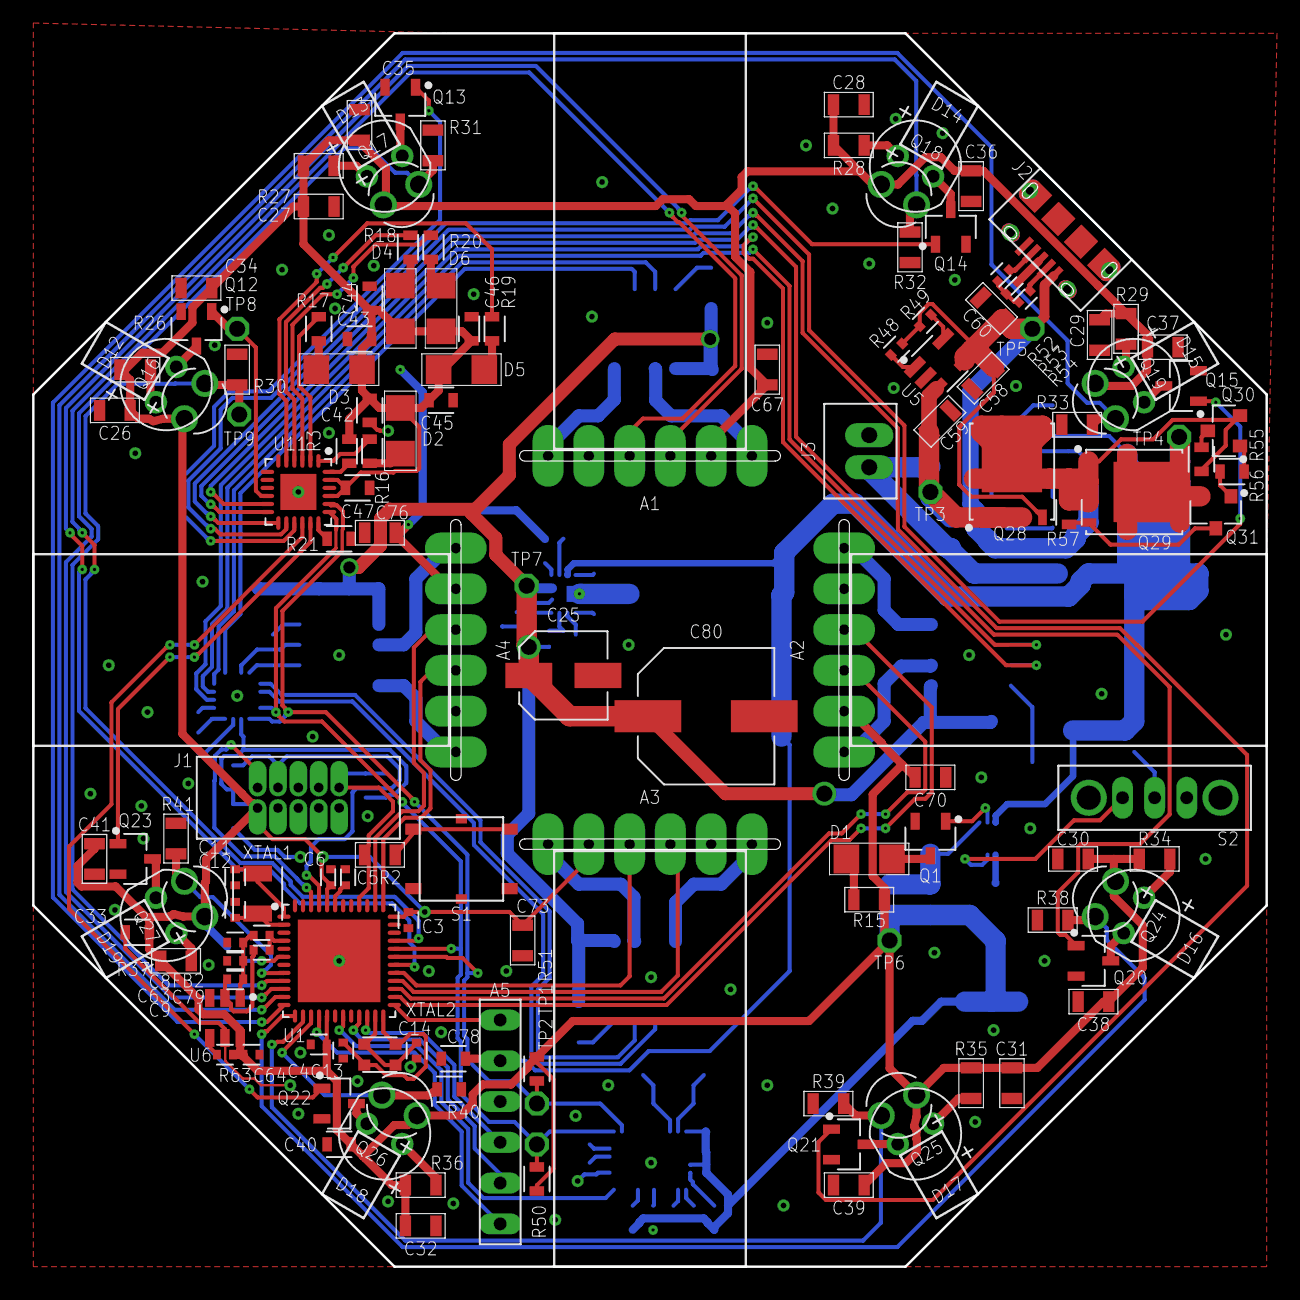
[picture p22: board Rev 1.brd from above]

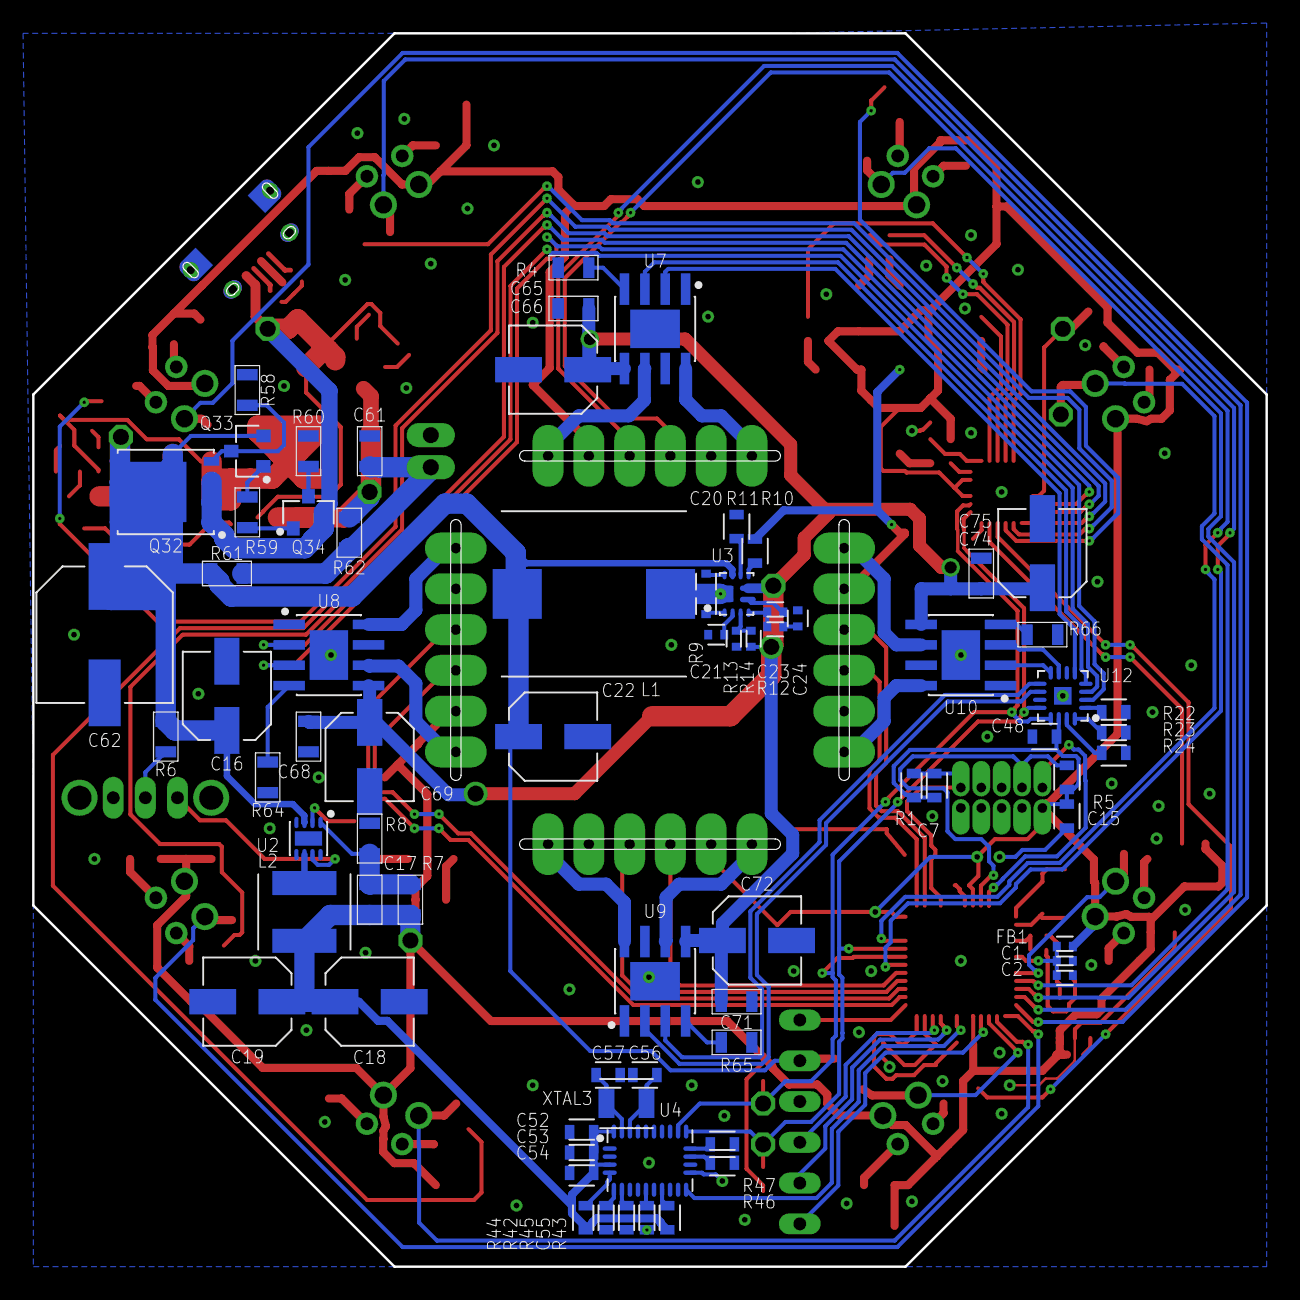
[picture p23: board Rev 1.brd from below]

Board: 2 copper layers, 76.8 x 76.8 mm, 216 parts (74 on the bottom side), 141 nets.
