akutney/micromouse2020/software/src/types/motor_outputs.h

/* 
 * motor_outputs.h
 *
 * Micromouse robot wheel definition:
 * 
 *         -------------
 *   FL  /               \  FR
 *     /                   \
 *   /          ^            \  
 *  |         / | \           |
 *  |           |             |
 *  |           |             |
 *   \                       /
 *     \                   /
 *   BL  \               /  BR
 *         -------------
 */

#ifndef __MOTOR_OUTPUTS_H__
#define __MOTOR_OUTPUTS_H__

#define NUM_OF_MOTORS 4

typedef enum
{
  MOTOR_FL = 0,
  MOTOR_FR = 1,
  MOTOR_BR = 2,
  MOTOR_BL = 3,
} motor_idx;

typedef struct
{
  /* Output motor data
   * Each array location corresponds to a motor by ID
   * Each value represents the desired angular speed in rotations per seconds
   * - A definition of the direction still needs to be made
   */
  float outputs[NUM_OF_MOTORS];
} motor_outputs_t;

#endif //__MOTOR_OUTPUTS_H__
