akutney/micromouse2020/software/src/types/types.h

/* 
 * types.h
 */

#ifndef __TYPES_H__
#define __TYPES_H__

// Inputs
#include "distance_sensor_data.h"
#include "encoder_data.h"
#include "imu_data.h"
#include "sensor_data.h"

// State
#include "robot_state.h"
#include "maze_state.h"

// Outputs
#include "motor_outputs.h"

#endif // __TYPES_H__
