akutney/micromouse2020/software/src/ASF/common2/boards/user_board/init.c

/**
 * \file
 *
 * \brief User board initialization template
 *
 */
/*
 * Support and FAQ: visit <a href="https://www.microchip.com/support/">Microchip Support</a>
 */

#include <asf.h>
#include <board.h>
#include <conf_board.h>

#if defined(__GNUC__)
void board_init(void) WEAK __attribute__((alias("system_board_init")));
#elif defined(__ICCARM__)
void board_init(void);
#pragma weak board_init = system_board_init
#endif

// Utility Function
void configure_gclk_source(uint8_t channel, enum gclk_generator source_generator);

// ASF module configuration functions
void configure_stdio_serial(void);
void configure_rtc_count(void);
void configure_adc(void);

void system_board_init(void)
{
  /* This function is meant to contain board-specific initialization code
     * for, e.g., the I/O pins. The initialization can rely on application-
     * specific board configuration, found in conf_board.h.
     */

  configure_stdio_serial();
  configure_rtc_count();
  configure_adc();
}

void configure_gclk_source(uint8_t channel, enum gclk_generator source_generator)
{
  /* Following 14.6.3.3 - Selecting a Clock Source for the Generic Clock */

  // 1. Write a zero to CLKCTRL.CLKEN
  system_gclk_chan_disable(channel);

  // 2. Wait until CLKCTRL.CLKEN reads as zero
  while (system_gclk_chan_is_enabled(channel))
    ;

  // 3. Change the source of the generic clock by writing CLKCTRL.GEN
  struct system_gclk_chan_config config_rtc_clk;
  system_gclk_chan_get_config_defaults(&config_rtc_clk);
  config_rtc_clk.source_generator = source_generator;
  system_gclk_chan_set_config(channel, &config_rtc_clk);

  // 4. Re-enable the generic clock by writing a one to CLKCTRL.CLKEN
  system_gclk_chan_enable(channel);
}

/**
 * After this function, stdio library should work
 */
void configure_stdio_serial(void)
{
  /* SERCOM0 clock source */
  configure_gclk_source(GCLK_CHANNEL_SERCOM0_CORE, GCLK_GENERATOR_0);

  /* SERCOM0 module configuration */
  struct usart_config config_usart;
  usart_get_config_defaults(&config_usart);
  config_usart.baudrate = 38400;
  config_usart.mux_setting = USART_RX_1_TX_0_XCK_1;
  config_usart.pinmux_pad0 = PINMUX_PA08C_SERCOM0_PAD0; // TX
  config_usart.pinmux_pad1 = PINMUX_PA09C_SERCOM0_PAD1; // RX/XCK // TODO: Use correct pins
  config_usart.pinmux_pad2 = PINMUX_UNUSED;
  config_usart.pinmux_pad3 = PINMUX_UNUSED;
  stdio_serial_init(&usart_instance, SERCOM0, &config_usart);

  usart_enable(&usart_instance);
}

void configure_rtc_count(void)
{
  /* RTC clock source */
  configure_gclk_source(GCLK_CHANNEL_RTC, GCLK_GENERATOR_2);

  /* RTC module configuration */
  enum status_code status;
  struct rtc_count_config config_rtc_count;
  rtc_count_get_config_defaults(&config_rtc_count);
  config_rtc_count.clear_on_match = false;
  //config_rtc_count.compare_values[0]  = ;
  //config_rtc_count.compare_values[1]  = ;
  config_rtc_count.mode = RTC_COUNT_MODE_32BIT;
  config_rtc_count.prescaler = 1;
  status = rtc_count_init(&rtc_instance, RTC, &config_rtc_count);

  if (status != STATUS_OK)
  {
    while (1)
      ; // Error, stop everything
  }
  // Will be enabled when needed
}

/**
 * Configure the adc module to read 12-bit analog values,
 * - 12-bit is default
 */
void configure_adc(void)
{
  /* ADC clock source */
  // configure_gclk_source(GCLK_ADC, GCLK_GENERATOR_0); // Done in adc_init()

  struct adc_config config_adc;
  adc_get_config_defaults(&config_adc);
  config_adc.reference = ADC_REFERENCE_AREFA;
  config_adc.positive_input = ADC_POSITIVE_INPUT_PIN4;
  config_adc.negative_input = ADC_NEGATIVE_INPUT_IOGND;
  config_adc.freerunning = false; // Set true for continuous recording

  config_adc.pin_scan.offset_start_scan = 0;
  config_adc.pin_scan.inputs_to_scan =    16;

  enum status_code status;
  while ((status = adc_init(&adc_instance, ADC, &config_adc)) != STATUS_OK)
  {
    if (status != STATUS_BUSY)
    {
      while (1)
        ; // Error, stop everything
    }
  }

  /* Don't need adc_init does this */
  //uint32_t pinArrary[NUM_OF_AIN] = {
  //PHOTO1_AIN, PHOTO2_AIN,
  //PHOTO3_AIN, PHOTO4_AIN,
  //PHOTO5_AIN, PHOTO6_AIN,
  //PHOTO7_AIN, PHOTO8_AIN,
  //};
  //
  //adc_regular_ain_channel((uint32_t*)&pinArrary, NUM_OF_AIN);

  // use adc_register_callback(...) instead
  //adc_enable_interrupt(&adc_instance, ADC_INTERRUPT_RESULT_READY);

  adc_enable(&adc_instance);
}
