akutney/micromouse2020/(commit log)

2019-10-17 Finished modeling the parts currently in the BOM
2019-10-22 Started schematic layout
    [Rev 1.sch]
2019-10-25 Worked on the schematic some more
    [Rev 1.sch]
2019-11-13 Started project setup, worked out configuration and driver interfaces
2019-11-20 Restructuring to set up testing framework
2019-11-20 Flipped north and south in probabalistic maze and standardized comment headers
    [testing.h]
2019-11-20 Did a lot of the schematic
    [Rev 1.sch]
2019-11-20 Added encoder schematic
    [EncoderR1.sch, Rev 1.sch]
2019-11-26 Updated the schematic
    [Rev 1.sch]
2019-12-04 Started to lay out board
    [Rev 1.brd, Rev 1.sch]
2019-12-06 Put the components that have a specific location on the board
    [Rev 1.brd]
2019-12-10 Locked reference designators
    [Rev 1.brd]
2019-12-11 Sorted into groups
    [Rev 1.brd, Rev 1.sch]
2019-12-11 Did some layout
    [Rev 1.brd]
2019-12-11 Fixed gitignore and added older clock
    [main.c]
2019-12-11 Started on rtc counter driver
2019-12-13 Added first version of error framework
    [error.c, error.h]
2019-12-13 Added drivers, types, and algorithms headers, disabled error framework
    [main.c]
2019-12-15 Fixed error.c compile errors
    [error.c, error.h]
2019-12-27 Placed the majority of the components
    [Rev 1.brd, Rev 1.sch]
2019-12-27 Placed the rest of the components
    [Rev 1.brd, Rev 1.sch]
2019-12-27 Added note about pin mappings
    [Rev 1.sch]
2019-12-27 Removed the DIP switches and some LEDs
    [Rev 1.brd, Rev 1.sch]
2020-01-02 Added IO expanders
    [Rev 1.brd, Rev 1.sch]
2020-01-02 Placed and routed IO expanders
    [Rev 1.brd, Rev 1.sch]
2020-01-02 Finished routing signals to MCU
    [Rev 1.brd, Rev 1.sch]
2020-01-02 Created ground plane and fixed DRC
    [Rev 1.brd]
2020-01-02 Created encoder board
    [EncoderR1.brd, EncoderR1.sch]
2020-01-02 Fixed passive type
    [Rev 1.sch]
2020-01-05 Created testing framework
2020-01-22 Converted from old testing framework
2020-01-22 Removed some files and fixed others
    [maze_state.test.c, testing.h]
2020-01-29 Fixed reference designators on silk screen
    [EncoderR1.brd, Rev 1.brd]
2020-01-31 Added pin definitions from schmatic
2020-01-31 Used better PORT in Pin definitions
2020-02-03 Fixed C7 that was somehow a resistor
    [Rev 1.brd, Rev 1.sch]
2020-02-04 Fixed crystal package
    [Rev 1.brd, Rev 1.sch]
2020-02-04 Switched power rail to HC-05
    [Rev 1.brd, Rev 1.sch]
2020-02-04 Changed pin mapping
    [Rev 1.brd, Rev 1.sch]
2020-02-26 Created gerbers
